LachlanPond/FlarmDisplay/Electronics/PCB/3DModels/PD3S0230.step

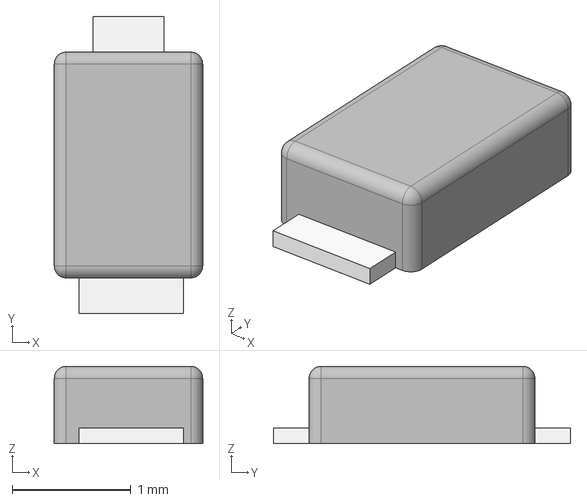
[picture p1: CAD file, 2022-05-21]
Electronics/PCB/3DModels/PD3S0230.step
1.25 x 2.50 x 0.65 mm
