LachlanPond/FlarmDisplay/Electronics/PCB/FlarmDisplay/FlarmDisplay.step

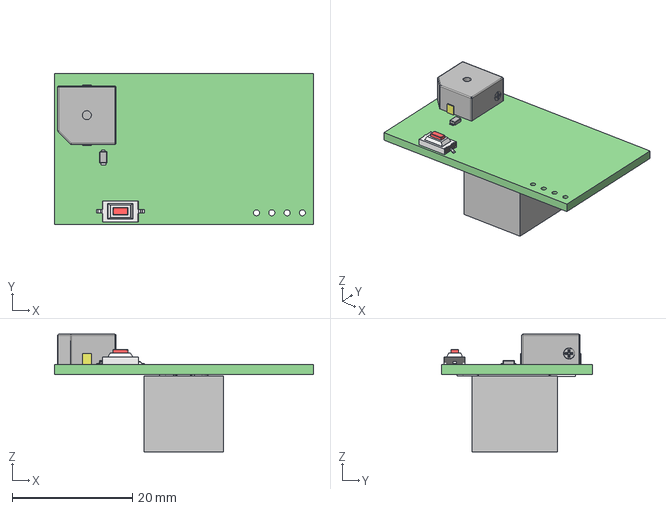
[picture p2: CAD file, 2022-05-22]
Electronics/PCB/FlarmDisplay/FlarmDisplay.step
43.0 x 25.0 x 19.5 mm
FlarmDisplay PCB
