LachlanPond/FlarmDisplay/Housing/Housing.FCStd

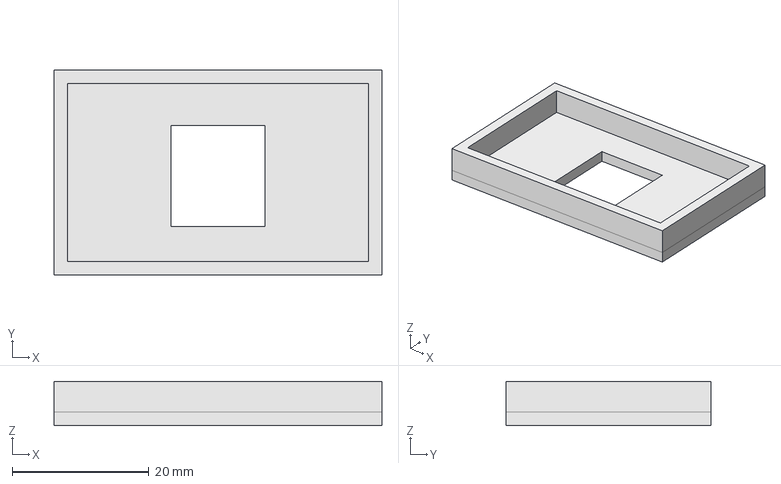
[picture p3: CAD file, 2022-05-22]
Housing/Housing.FCStd
48.0 x 30.0 x 6.50 mm
