LachlanPond/FlarmDisplay/Electronics/PCB/3DModels/M-RJE23-166-0X13-T-REVT1.STEP

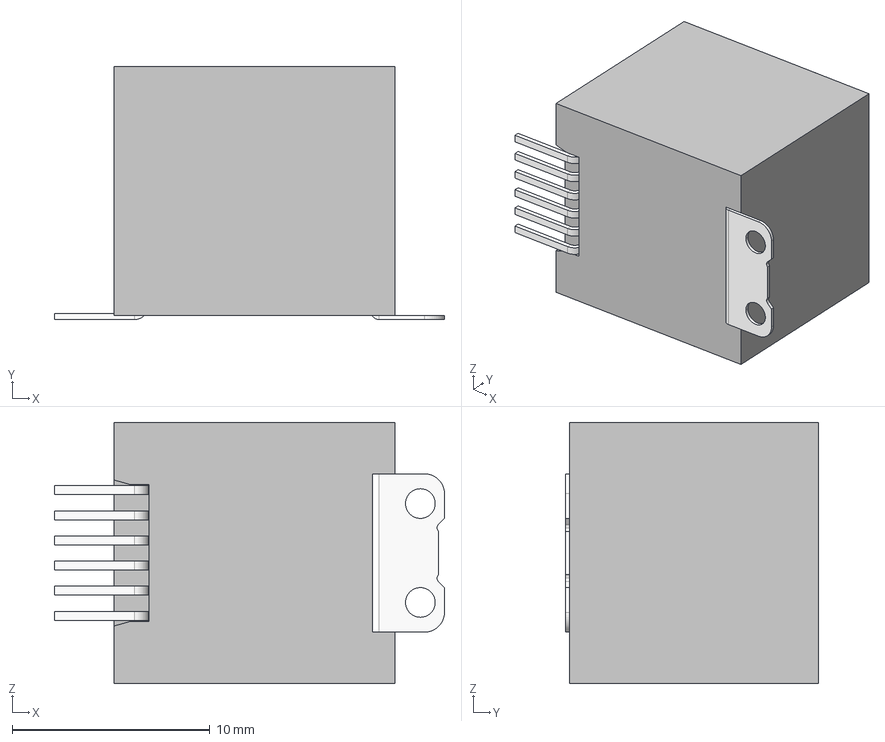
[picture p4: CAD file, 2022-05-21]
Electronics/PCB/3DModels/M-RJE23-166-0X13-T-REVT1.STEP
19.7 x 12.8 x 13.2 mm
