LachlanPond/FlarmDisplay/Electronics/PCB/3DModels/CUI_DEVICES_CMI-9705-0380-SMT-TR.step

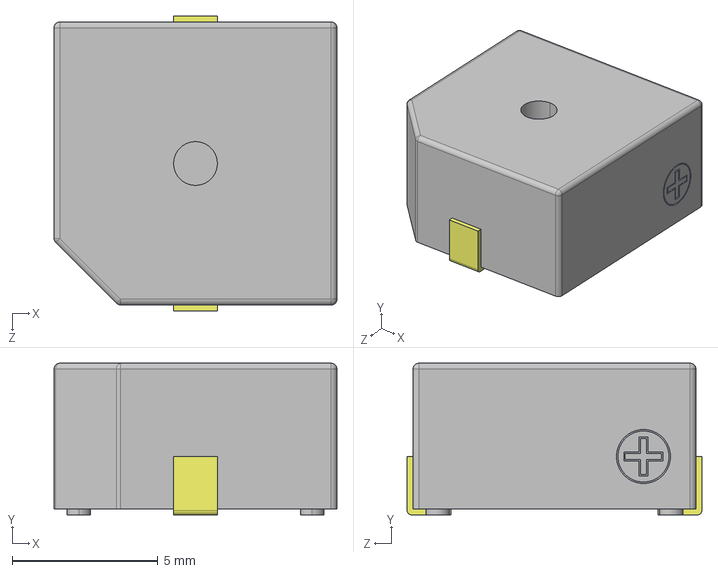
[picture p5: CAD file, 2022-05-20]
Electronics/PCB/3DModels/CUI_DEVICES_CMI-9705-0380-SMT-TR.step
9.70 x 5.20 x 10.1 mm
