LachlanPond/FlarmDisplay/Electronics/PCB/3DModels/7814G001XXX.step

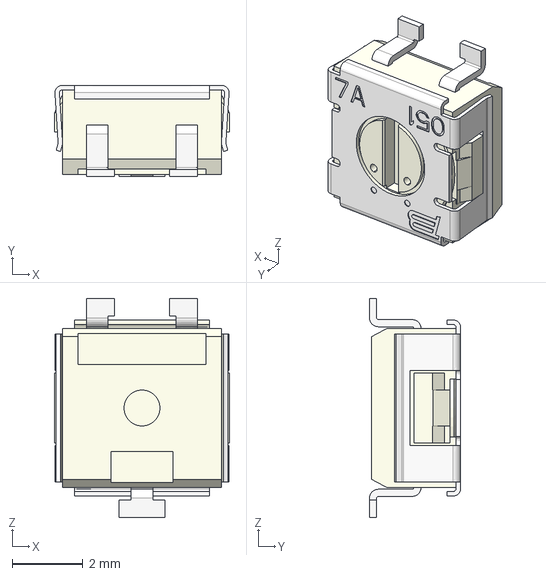
[picture p6: CAD file, 2022-05-21]
Electronics/PCB/3DModels/7814G001XXX.step
4.95 x 2.58 x 6.20 mm
