LachlanPond/FlarmDisplay/Electronics/PCB/FlarmDisplay/FlarmDisplay.kicad_pcb

## KiCad design Electronics/PCB/FlarmDisplay/FlarmDisplay.kicad_pcb (2022-06-11)

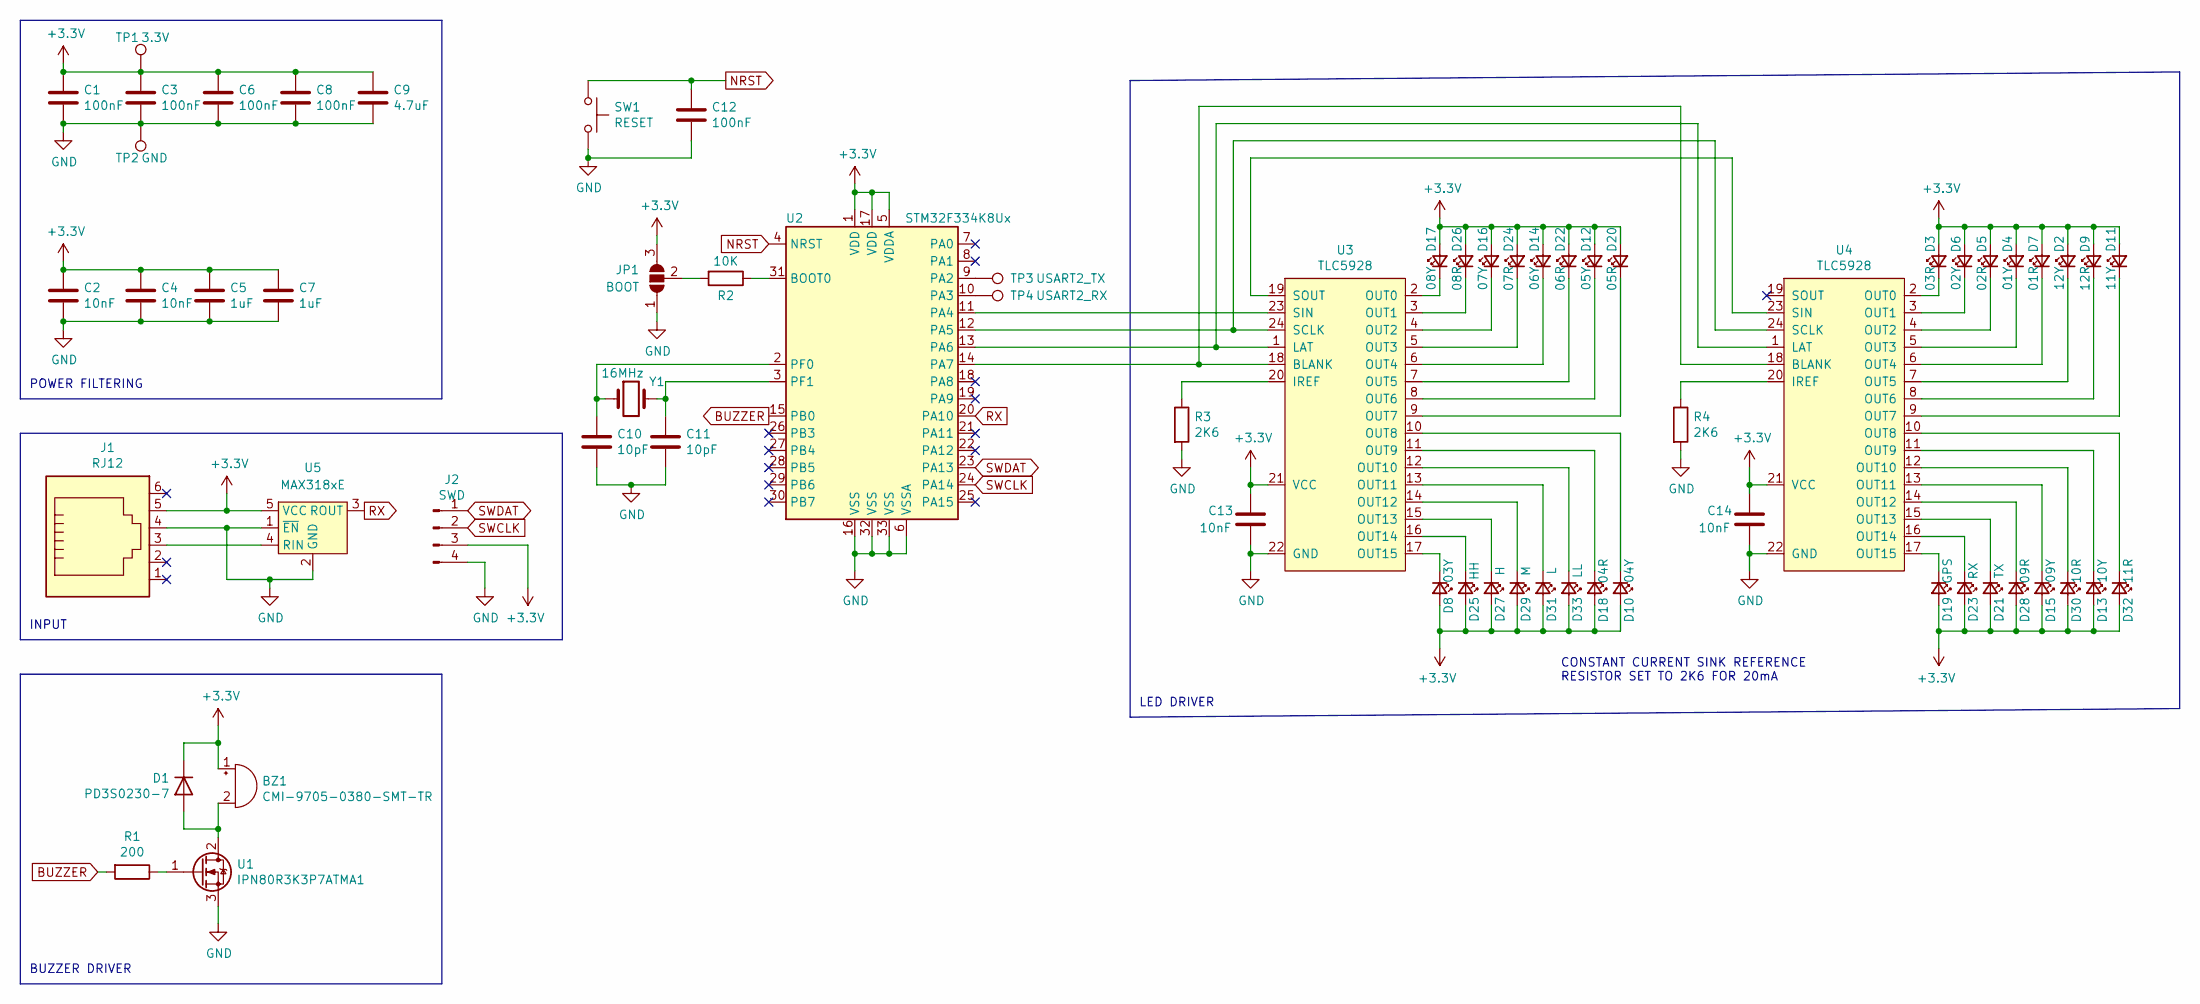
[picture p7: schematic FlarmDisplay.kicad_sch]

Parts:
BZ1: CMI-9705-0380-SMT-TR
C1, C3, C6, C8, C12: 100nF; C_0402_1005Metric
C2, C4, C13, C14: 10nF; C_0402_1005Metric
C5, C7: 1uF; C_0402_1005Metric
C9: 4.7uF; C_0805_2012Metric
C10, C11: 10pF; C_0402_1005Metric
D1: PD3S0230-7; POWERDI323
D2: 12Y; LED_0805_2012Metric
D3: 03R; LED_0805_2012Metric
D4: 01Y; LED_0805_2012Metric
D5: 02R; LED_0805_2012Metric
D6: 02Y; LED_0805_2012Metric
D7: 01R; LED_0805_2012Metric
D8: 03Y; LED_0805_2012Metric
D9: 12R; LED_0805_2012Metric
D10: 04Y; LED_0805_2012Metric
D11: 11Y; LED_0805_2012Metric
D12: 05Y; LED_0805_2012Metric
D13: 10Y; LED_0805_2012Metric
D14: 06Y; LED_0805_2012Metric
D15: 09Y; LED_0805_2012Metric
D16: 07Y; LED_0805_2012Metric
D17: 08Y; LED_0805_2012Metric
D18: 04R; LED_0805_2012Metric
D19: GPS; LED_0805_2012Metric
D20: 05R; LED_0805_2012Metric
D21: TX; LED_0805_2012Metric
D22: 06R; LED_0805_2012Metric
D23: RX; LED_0805_2012Metric
D24: 07R; LED_0805_2012Metric
D25: HH; LED_0805_2012Metric
D26: 08R; LED_0805_2012Metric
D27: H; LED_0805_2012Metric
D28: 09R; LED_0805_2012Metric
D29: M; LED_0805_2012Metric
D30: 10R; LED_0805_2012Metric
D31: L; LED_0805_2012Metric
D32: 11R; LED_0805_2012Metric
D33: LL; LED_0805_2012Metric
J1: RJ12; RJE231660413T
J2: SWD; PinHeader_1x04_P2.54mm_Vertical
JP1: BOOT; SolderJumper-3_P1.3mm_Open_RoundedPad1.0x1.5mm
R1: 200; R_0402_1005Metric
R2: 10K; R_0402_1005Metric
R3, R4: 2K6; R_0402_1005Metric
SW1: RESET; SMT_J
TP1: 3.3V; TestPoint_Pad_D2.0mm
TP2: GND; TestPoint_Pad_D2.0mm
TP3: USART2_TX; TestPoint_Pad_D2.0mm
TP4: USART2_RX; TestPoint_Pad_D2.0mm
U1: IPN80R3K3P7ATMA1; SOT-223-3_TabPin2
U2: STM32F334K8Ux; QFN-32-1EP_5x5mm_P0.5mm_EP3.45x3.45mm
U3, U4: TLC5928; VQFN-24-1EP_4x4mm_P0.5mm_EP2.45x2.45mm
U5: MAX318xE; SOT-23-5
Y1: 16MHz; Crystal_SMD_3225-4Pin_3.2x2.5mm

Connections:
+3V3: BZ1.1 (-), C1.1, C2.1, C3.1, C4.1, C5.1, C6.1, C7.1, C8.1, C9.1, C13.1, C14.1, D1.1 (K), D2.2 (A), D3.2 (A), D4.2 (A), D5.2 (A), D6.2 (A), D7.2 (A), D8.2 (A), D9.2 (A), D10.2 (A), D11.2 (A), D12.2 (A), D13.2 (A), D14.2 (A), D15.2 (A), D16.2 (A), D17.2 (A), D18.2 (A), D19.2 (A), D20.2 (A), D21.2 (A), D22.2 (A), D23.2 (A), D24.2 (A), D25.2 (A), D26.2 (A), D27.2 (A), D28.2 (A), D29.2 (A), D30.2 (A), D31.2 (A), D32.2 (A), D33.2 (A), J1.5, J2.3, JP1.3 (B), TP1.1, U2.1 (VDD), U2.5 (VDDA), U2.17 (VDD), U3.21 (VCC), U4.21 (VCC), U5.5 (VCC); also elsewhere on the board
BUZZER: R1.2, U2.15 (PB0)
GND: C1.2, C2.2, C3.2, C4.2, C5.2, C6.2, C7.2, C8.2, C9.2, C10.2, C11.2, C12.2, C13.2, C14.2, J1.4, J2.4, JP1.1 (A), R3.2, R4.2, SW1.2, TP2.1, U1.3, U2.6 (VSSA), U2.16 (VSS), U2.32 (VSS), U2.33 (VSS), U3.22 (GND), U4.22 (GND), U5.1 (~EN), U5.2 (GND)
NRST: C12.1, SW1.1, U2.4 (NRST)
unnamed: BZ1.2 (+), D1.2 (A), U1.2
unnamed: C10.1, U2.2 (PF0), Y1.1
unnamed: C11.1, U2.3 (PF1), Y1.2
unnamed: D2.1 (K), U4.7 (OUT5)
unnamed: D3.1 (K), U4.2 (OUT0)
unnamed: D4.1 (K), U4.5 (OUT3)
unnamed: D5.1 (K), U4.4 (OUT2)
unnamed: D6.1 (K), U4.3 (OUT1)
unnamed: D7.1 (K), U4.6 (OUT4)
unnamed: D8.1 (K), U3.17 (OUT15)
unnamed: D9.1 (K), U4.8 (OUT6)
unnamed: D10.1 (K), U3.10 (OUT8)
unnamed: D11.1 (K), U4.9 (OUT7)
unnamed: D12.1 (K), U3.8 (OUT6)
unnamed: D13.1 (K), U4.11 (OUT9)
unnamed: D14.1 (K), U3.6 (OUT4)
unnamed: D15.1 (K), U4.13 (OUT11)
unnamed: D16.1 (K), U3.4 (OUT2)
unnamed: D17.1 (K), U3.2 (OUT0)
unnamed: D18.1 (K), U3.11 (OUT9)
unnamed: D19.1 (K), U4.17 (OUT15)
unnamed: D20.1 (K), U3.9 (OUT7)
unnamed: D21.1 (K), U4.15 (OUT13)
unnamed: D22.1 (K), U3.7 (OUT5)
unnamed: D23.1 (K), U4.16 (OUT14)
unnamed: D24.1 (K), U3.5 (OUT3)
unnamed: D25.1 (K), U3.16 (OUT14)
unnamed: D26.1 (K), U3.3 (OUT1)
unnamed: D27.1 (K), U3.15 (OUT13)
unnamed: D28.1 (K), U4.14 (OUT12)
unnamed: D29.1 (K), U3.14 (OUT12)
unnamed: D30.1 (K), U4.12 (OUT10)
unnamed: D31.1 (K), U3.13 (OUT11)
unnamed: D32.1 (K), U4.10 (OUT8)
unnamed: D33.1 (K), U3.12 (OUT10)
unnamed: J1.3, U5.4 (RIN)
unnamed: R1.1, U1.1
unnamed: R2.1, U2.31 (BOOT0)
unnamed: JP1.2 (C), R2.2
unnamed: R3.1, U3.20 (IREF)
unnamed: R4.1, U4.20 (IREF)
unnamed 45: TP3.1, U2.9 (PA2); also elsewhere on the board
unnamed 46: TP4.1, U2.10 (PA3); also elsewhere on the board
unnamed: U2.11 (PA4), U3.23 (SIN)
unnamed: U2.12 (PA5), U3.24 (SCLK), U4.24 (SCLK)
unnamed: U2.13 (PA6), U3.1 (LAT), U4.1 (LAT)
unnamed: U2.14 (PA7), U3.18 (BLANK), U4.18 (BLANK)
unnamed: U3.19 (SOUT), U4.23 (SIN)
RX: U2.20 (PA10), U5.3 (ROUT)
SWCLK: J2.2, U2.24 (PA14)
SWDAT: J2.1, U2.23 (PA13)

Notes on the sheet:
INPUT
LED DRIVER
POWER FILTERING
BUZZER DRIVER
CONSTANT CURRENT SINK REFERENCE RESISTOR SET TO 2K6 FOR 20mA

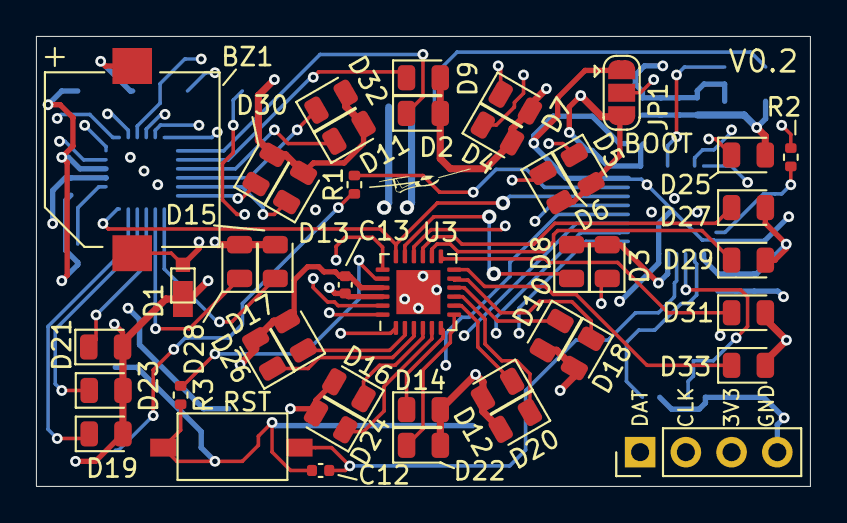
[picture p8: board FlarmDisplay.kicad_pcb from above]

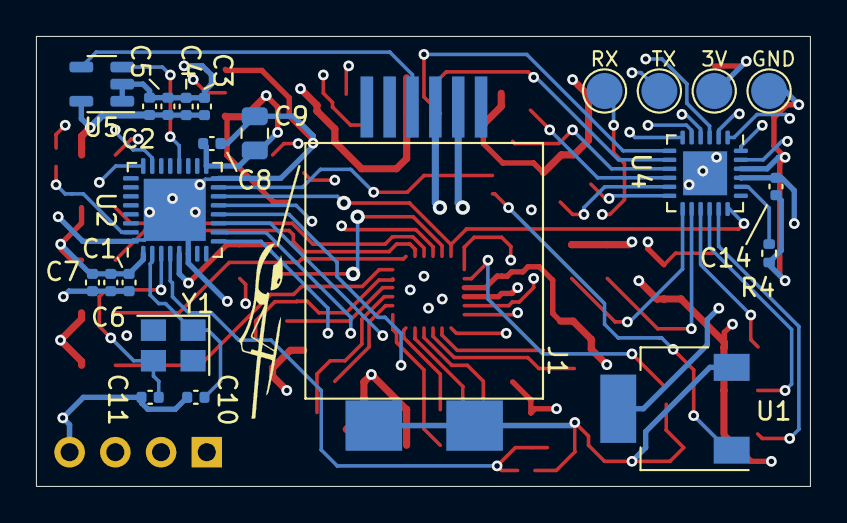
[picture p9: board FlarmDisplay.kicad_pcb from below]

Board: 4 copper layers, 43.0 x 25.0 mm, 66 parts (23 on the bottom side), 55 nets.

Other parts of the board:
3V: 3.3V; TestPoint_Pad_D2.0mm
RX: USART2_RX; TestPoint_Pad_D2.0mm
TX: USART2_TX; TestPoint_Pad_D2.0mm

Their connections:
+3V3: 3V.1; also elsewhere on the board
unnamed 45: TX.1; also elsewhere on the board
unnamed 46: RX.1; also elsewhere on the board
