LachlanPond/FlarmDisplay/Electronics/Firmware/Core/Src/main.c

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
/* Includes ------------------------------------------------------------------*/
#include "main.h"

/* USER CODE BEGIN Includes */
#include "flarm.h"
/* USER CODE END Includes */

UART_HandleTypeDef huart1;
UART_HandleTypeDef huart2;

/* USER CODE BEGIN PV */
struct LEDRegister LEDreg;
struct errorRegister errorReg;
enum errors errors;
/* USER CODE END PV */

void SystemClock_Config(void);
static void MX_GPIO_Init(void);
static void MX_USART1_UART_Init(void);
static void MX_USART2_UART_Init(void);
/* USER CODE BEGIN PFP */
void displayLEDBuffer(struct LEDRegister *reg);
void displayClockPulse();
void displayLatch();
void displayErrors();
/* USER CODE END PFP */

/**
 * @brief  The application entry point.
 * @retval int
 */
int main(void) {
	/* MCU Configuration--------------------------------------------------------*/

	/* Reset of all peripherals, Initializes the Flash interface and the Systick. */
	HAL_Init();

	/* Configure the system clock */
	SystemClock_Config();

	/* Initialize all configured peripherals */
	MX_GPIO_Init();
	MX_USART1_UART_Init();
	MX_USART2_UART_Init();
	/* USER CODE BEGIN 2 */

	uint8_t startMsg[] = "Starting...";
	HAL_UART_Transmit(&huart1, startMsg, sizeof(startMsg), 10);

	/* USER CODE END 2 */

	/* Infinite loop */
	/* USER CODE BEGIN WHILE */
	while (1) {
		//processPFLAE("$PFLAE,A,0,12,Supa message*50", &errorReg);
		LEDreg.R01 = 1;
		serializeLEDRegister(&LEDreg);
		displayLEDBuffer(&LEDreg);
		clearLEDRegister(&LEDreg);
		HAL_Delay(100);
		LEDreg.R02 = 1;
		serializeLEDRegister(&LEDreg);
		displayLEDBuffer(&LEDreg);
		clearLEDRegister(&LEDreg);
		HAL_Delay(100);
		LEDreg.R03 = 1;
		serializeLEDRegister(&LEDreg);
		displayLEDBuffer(&LEDreg);
		clearLEDRegister(&LEDreg);
		HAL_Delay(100);
		LEDreg.R04 = 1;
		serializeLEDRegister(&LEDreg);
		displayLEDBuffer(&LEDreg);
		clearLEDRegister(&LEDreg);
		HAL_Delay(100);
		LEDreg.R05 = 1;
		serializeLEDRegister(&LEDreg);
		displayLEDBuffer(&LEDreg);
		clearLEDRegister(&LEDreg);
		HAL_Delay(100);
		LEDreg.R06 = 1;
		serializeLEDRegister(&LEDreg);
		displayLEDBuffer(&LEDreg);
		clearLEDRegister(&LEDreg);
		HAL_Delay(100);
		LEDreg.R07 = 1;
		serializeLEDRegister(&LEDreg);
		displayLEDBuffer(&LEDreg);
		clearLEDRegister(&LEDreg);
		HAL_Delay(100);
		LEDreg.R08 = 1;
		serializeLEDRegister(&LEDreg);
		displayLEDBuffer(&LEDreg);
		clearLEDRegister(&LEDreg);
		HAL_Delay(100);
		LEDreg.R09 = 1;
		serializeLEDRegister(&LEDreg);
		displayLEDBuffer(&LEDreg);
		clearLEDRegister(&LEDreg);
		HAL_Delay(100);
		LEDreg.R10 = 1;
		serializeLEDRegister(&LEDreg);
		displayLEDBuffer(&LEDreg);
		clearLEDRegister(&LEDreg);
		HAL_Delay(100);
		LEDreg.R11 = 1;
		serializeLEDRegister(&LEDreg);
		displayLEDBuffer(&LEDreg);
		clearLEDRegister(&LEDreg);
		HAL_Delay(100);
		LEDreg.R12 = 1;
		serializeLEDRegister(&LEDreg);
		displayLEDBuffer(&LEDreg);
		clearLEDRegister(&LEDreg);
		HAL_Delay(100);
		LEDreg.Y01 = 1;
		serializeLEDRegister(&LEDreg);
		displayLEDBuffer(&LEDreg);
		clearLEDRegister(&LEDreg);
		HAL_Delay(100);
		LEDreg.Y02 = 1;
		serializeLEDRegister(&LEDreg);
		displayLEDBuffer(&LEDreg);
		clearLEDRegister(&LEDreg);
		HAL_Delay(100);
		LEDreg.Y03 = 1;
		serializeLEDRegister(&LEDreg);
		displayLEDBuffer(&LEDreg);
		clearLEDRegister(&LEDreg);
		HAL_Delay(100);
		LEDreg.Y04 = 1;
		serializeLEDRegister(&LEDreg);
		displayLEDBuffer(&LEDreg);
		clearLEDRegister(&LEDreg);
		HAL_Delay(100);
		LEDreg.Y05 = 1;
		serializeLEDRegister(&LEDreg);
		displayLEDBuffer(&LEDreg);
		clearLEDRegister(&LEDreg);
		HAL_Delay(100);
		LEDreg.Y06 = 1;
		serializeLEDRegister(&LEDreg);
		displayLEDBuffer(&LEDreg);
		clearLEDRegister(&LEDreg);
		HAL_Delay(100);
		LEDreg.Y07 = 1;
		serializeLEDRegister(&LEDreg);
		displayLEDBuffer(&LEDreg);
		clearLEDRegister(&LEDreg);
		HAL_Delay(100);
		LEDreg.Y08 = 1;
		serializeLEDRegister(&LEDreg);
		displayLEDBuffer(&LEDreg);
		clearLEDRegister(&LEDreg);
		HAL_Delay(100);
		LEDreg.Y09 = 1;
		serializeLEDRegister(&LEDreg);
		displayLEDBuffer(&LEDreg);
		clearLEDRegister(&LEDreg);
		HAL_Delay(100);
		LEDreg.Y10 = 1;
		serializeLEDRegister(&LEDreg);
		displayLEDBuffer(&LEDreg);
		clearLEDRegister(&LEDreg);
		HAL_Delay(100);
		LEDreg.Y11 = 1;
		serializeLEDRegister(&LEDreg);
		displayLEDBuffer(&LEDreg);
		clearLEDRegister(&LEDreg);
		HAL_Delay(100);
		LEDreg.Y12 = 1;
		serializeLEDRegister(&LEDreg);
		displayLEDBuffer(&LEDreg);
		clearLEDRegister(&LEDreg);
		HAL_Delay(100);
		LEDreg.GPS = 1;
		serializeLEDRegister(&LEDreg);
		displayLEDBuffer(&LEDreg);
		clearLEDRegister(&LEDreg);
		HAL_Delay(100);
		LEDreg.RX = 1;
		serializeLEDRegister(&LEDreg);
		displayLEDBuffer(&LEDreg);
		clearLEDRegister(&LEDreg);
		HAL_Delay(100);
		LEDreg.TX = 1;
		serializeLEDRegister(&LEDreg);
		displayLEDBuffer(&LEDreg);
		clearLEDRegister(&LEDreg);
		HAL_Delay(100);
		LEDreg.LL = 1;
		serializeLEDRegister(&LEDreg);
		displayLEDBuffer(&LEDreg);
		clearLEDRegister(&LEDreg);
		HAL_Delay(100);
		LEDreg.L = 1;
		serializeLEDRegister(&LEDreg);
		displayLEDBuffer(&LEDreg);
		clearLEDRegister(&LEDreg);
		HAL_Delay(100);
		LEDreg.M = 1;
		serializeLEDRegister(&LEDreg);
		displayLEDBuffer(&LEDreg);
		clearLEDRegister(&LEDreg);
		HAL_Delay(100);
		LEDreg.H = 1;
		serializeLEDRegister(&LEDreg);
		displayLEDBuffer(&LEDreg);
		clearLEDRegister(&LEDreg);
		HAL_Delay(100);
		LEDreg.HH = 1;
		serializeLEDRegister(&LEDreg);
		displayLEDBuffer(&LEDreg);
		clearLEDRegister(&LEDreg);
		HAL_Delay(100);
		/* USER CODE END WHILE */

		/* USER CODE BEGIN 3 */
	}
	/* USER CODE END 3 */
}

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
/* USER CODE BEGIN 4 */

void displayLEDBuffer(struct LEDRegister *reg) {
	for (int i = 0; i < LED_BUFFER_SIZE; i++) {
		if (reg->Buffer >> i & 1) {
			HAL_GPIO_WritePin(GPIOA, GPIO_PIN_4, GPIO_PIN_SET);
		} else {
			HAL_GPIO_WritePin(GPIOA, GPIO_PIN_4, GPIO_PIN_RESET);
		}
		displayClockPulse();
	}
	displayLatch();
}

void displayClockPulse() {
	HAL_GPIO_WritePin(GPIOA, GPIO_PIN_5, GPIO_PIN_SET);
	HAL_GPIO_WritePin(GPIOA, GPIO_PIN_5, GPIO_PIN_RESET);
}

void displayLatch() {
	HAL_GPIO_WritePin(GPIOA, GPIO_PIN_6, GPIO_PIN_SET);
	HAL_GPIO_WritePin(GPIOA, GPIO_PIN_6, GPIO_PIN_RESET);
}

void displayErrors() {
	if (FIRMWAREEXPIRED) {

	}
}

/* USER CODE END 4 */
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
