LachlanPond/FlarmDisplay/Electronics/Firmware/Core/Inc/main.h

#define SIN_Pin GPIO_PIN_4
#define SIN_GPIO_Port GPIOA
#define SCLK_Pin GPIO_PIN_5
#define SCLK_GPIO_Port GPIOA
#define LAT_Pin GPIO_PIN_6
#define LAT_GPIO_Port GPIOA
#define BLANK_Pin GPIO_PIN_7
#define BLANK_GPIO_Port GPIOA
#define BUZZER_Pin GPIO_PIN_0
#define BUZZER_GPIO_Port GPIOB
