LachlanPond/FlarmDisplay/(commit log)

2022-05-14 Majority of schematic complete
    [FlarmDisplay.kicad_pcb, FlarmDisplay.sch]
2022-05-15 Initial schematic version complete
    [FlarmDisplay.sch]
2022-05-17 Started work on PCB, most placement done
    [FlarmDisplay.kicad_pcb, FlarmDisplay.sch]
2022-05-20 Completed routing, main silk items, 3D models still to go
    [FlarmDisplay.kicad_pcb, FlarmDisplay.kicad_sch, M-RJE23-166-0X13-T-REVT1.STEP]
2022-05-21 Completed v1.0
    [7814G001XXX.step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]
2022-05-22 Started work on NMEA test scripts
    [FlarmDisplay.kicad_sch, FlarmDisplay.step, Housing.FCStd]
2022-05-27 Updated PCB to v0.2
    [FlarmDisplay-B_Cu.gbl, FlarmDisplay-B_Mask.gbs, FlarmDisplay-B_Paste.gbp, FlarmDisplay-B_Silkscreen.gbo, FlarmDisplay-Edge_Cuts.gm1, FlarmDisplay-F_Cu.gtl, FlarmDisplay-F_Mask.gts, FlarmDisplay-F_Paste.gtp]
2022-06-11 Basic firmware LED test working
    [FlarmDisplay.kicad_pcb, FlarmDisplay.kicad_sch]
2022-06-12 Progress on error packet handling
    [flarm.c, flarm.h, main.c, serial_test.ino]
2024-04-20 Started developing the firmare in Rust
    [FlarmDisplay.kicad_sch]
